trsh-mn/smart-home-iot/docs/images/lamp_v1_schematic.png

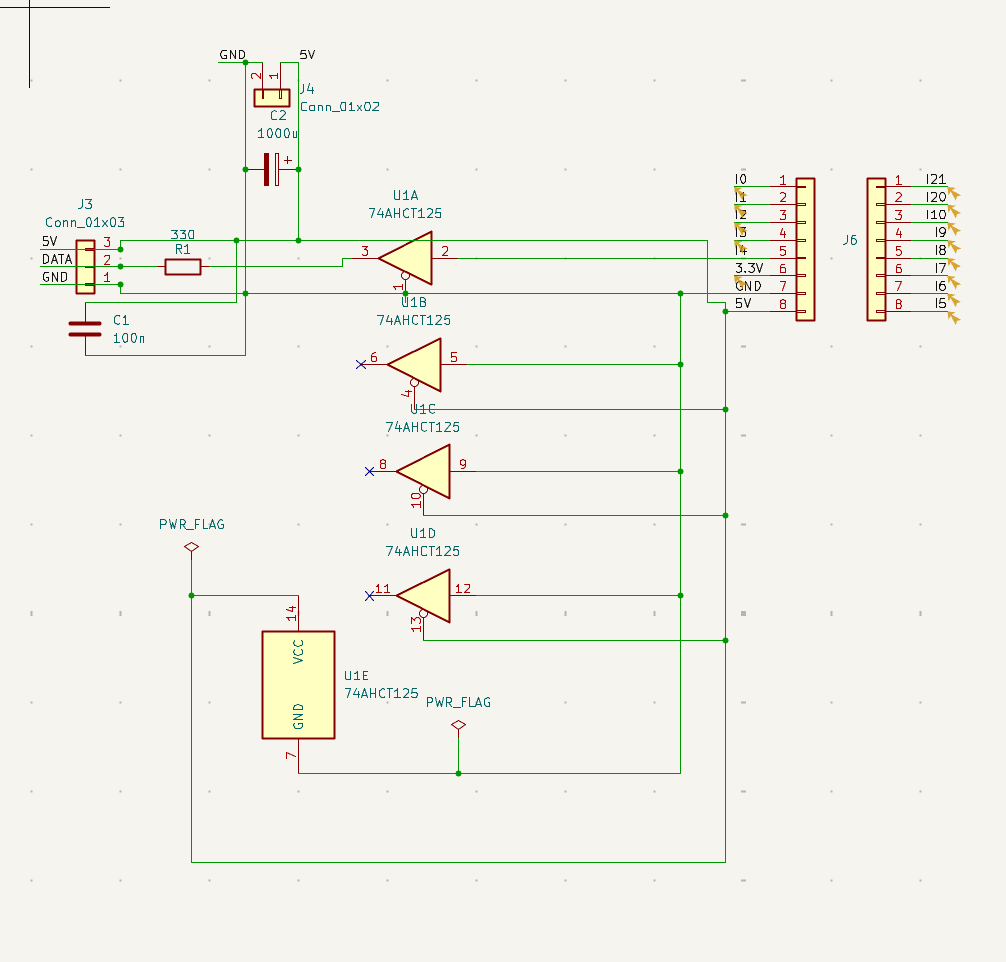
docs/images/lamp_v1_schematic.png
