trsh-mn/smart-home-iot/docs/images/lamp_v2_schematic.png

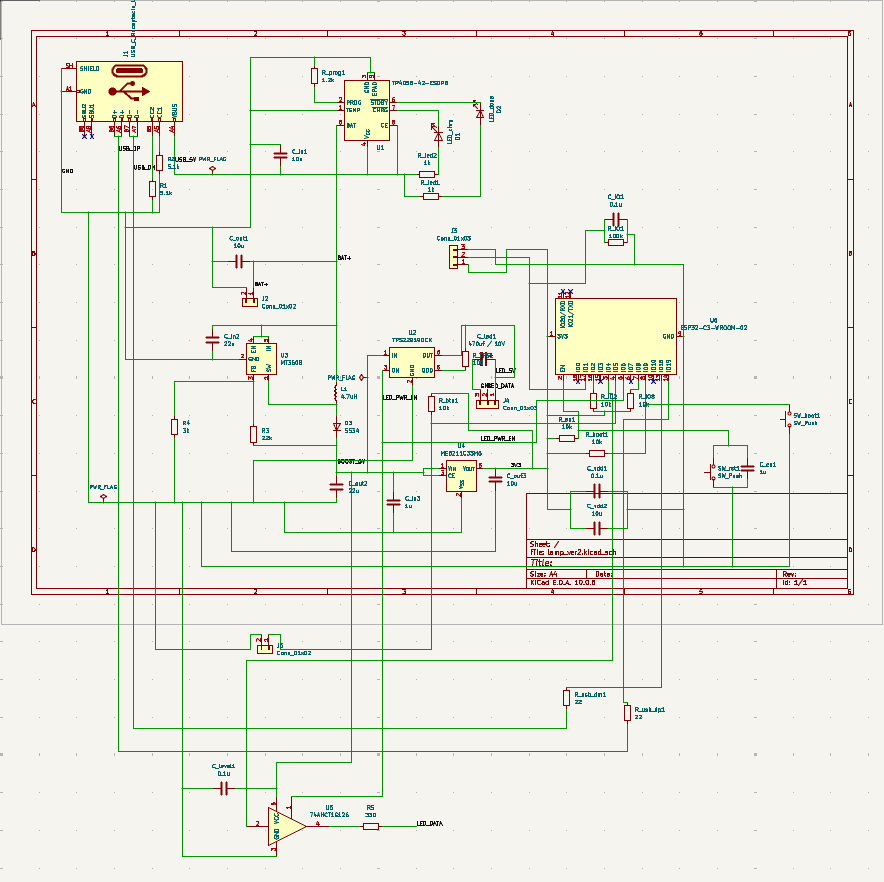
docs/images/lamp_v2_schematic.png
