trsh-mn/smart-home-iot/hardware/lamp_v1/전등.kicad_pcb

## KiCad design hardware/lamp_v1/전등.kicad_pcb (2026-10-02, an earlier design)

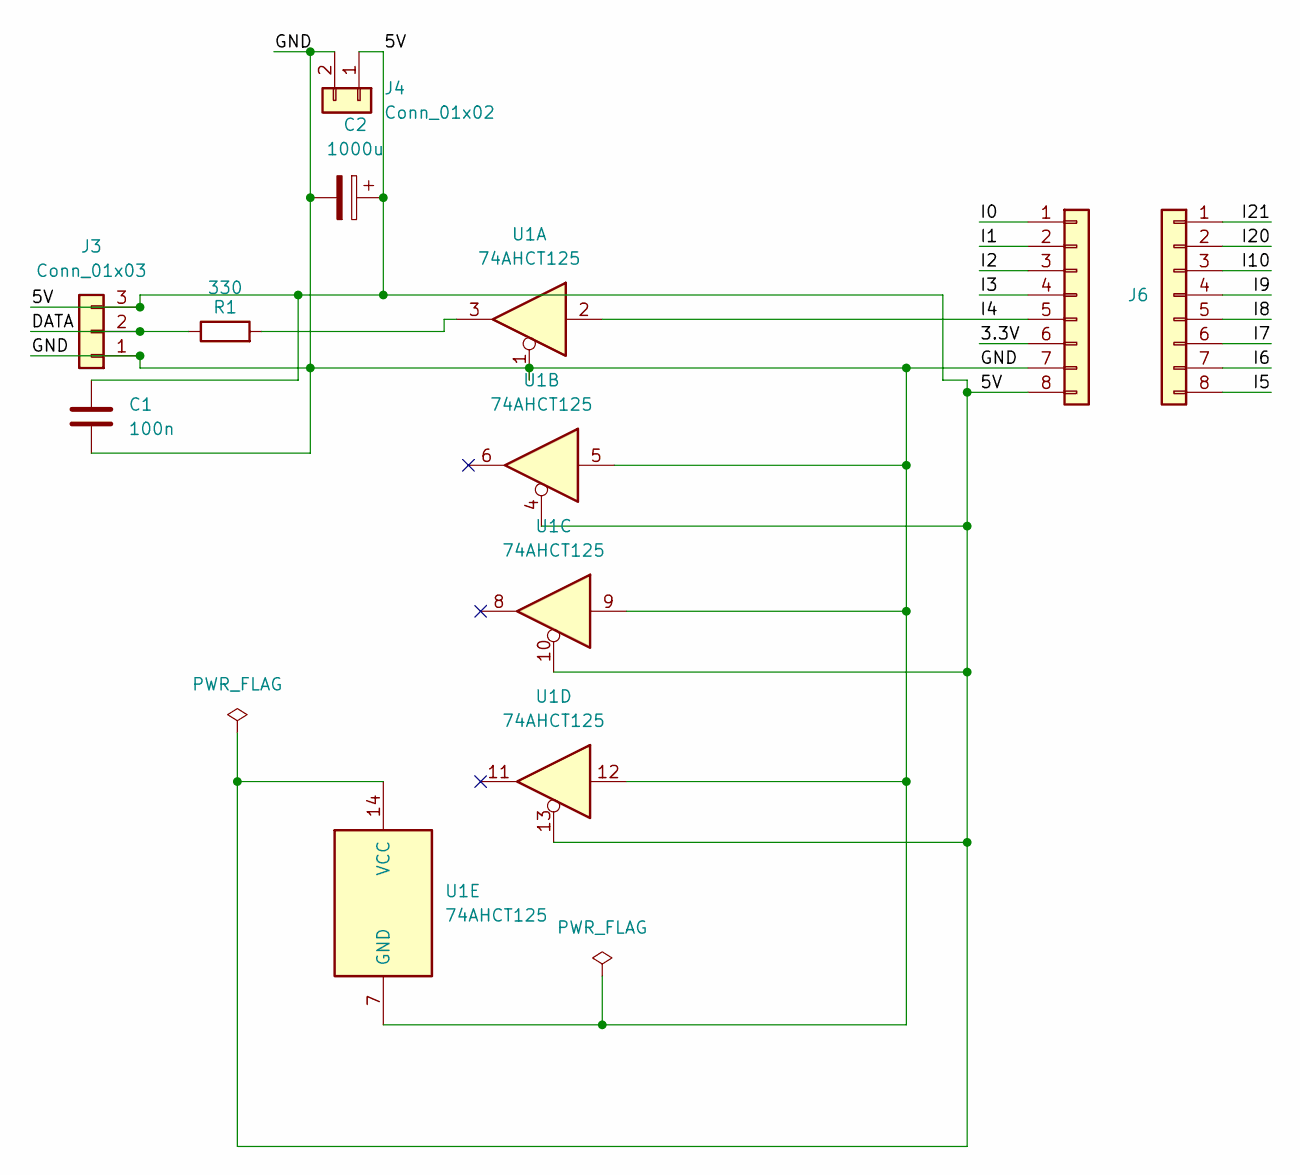
[picture p9: schematic 전등.kicad_sch]

Parts:
C1: 100n; C_0805_2012Metric
C2: 1000u; CP_Radial_D8.0mm_P3.50mm
J3: Conn_01x03; PinHeader_1x03_P2.54mm_Vertical
J4: Conn_01x02; PinHeader_1x02_P2.54mm_Vertical
J5, J6: Conn_01x08; PinSocket_1x08_P2.54mm_Vertical
R1: 330; R_0805_2012Metric
U1: 74AHCT125; SOIC-14_3.9x8.7mm_P1.27mm

Connections:
/3.3V: J5.6
/5V: C1.1, C2.1, J3.3, J4.1, J5.8, U1.4, U1.10, U1.13, U1.14 (VCC)
/DATA: J3.2, R1.1
/GND: C1.2, C2.2, J3.1, J4.2, J5.7, U1.1, U1.5, U1.7 (GND), U1.9, U1.12
/I0: J5.1
/I1: J5.2
/I2: J5.3
/I3: J5.4
/I4: J5.5, U1.2
/I5: J6.8
/I6: J6.7
/I7: J6.6
/I8: J6.5
/I9: J6.4
/I10: J6.3
/I20: J6.2
/I21: J6.1
unnamed: R1.2, U1.3

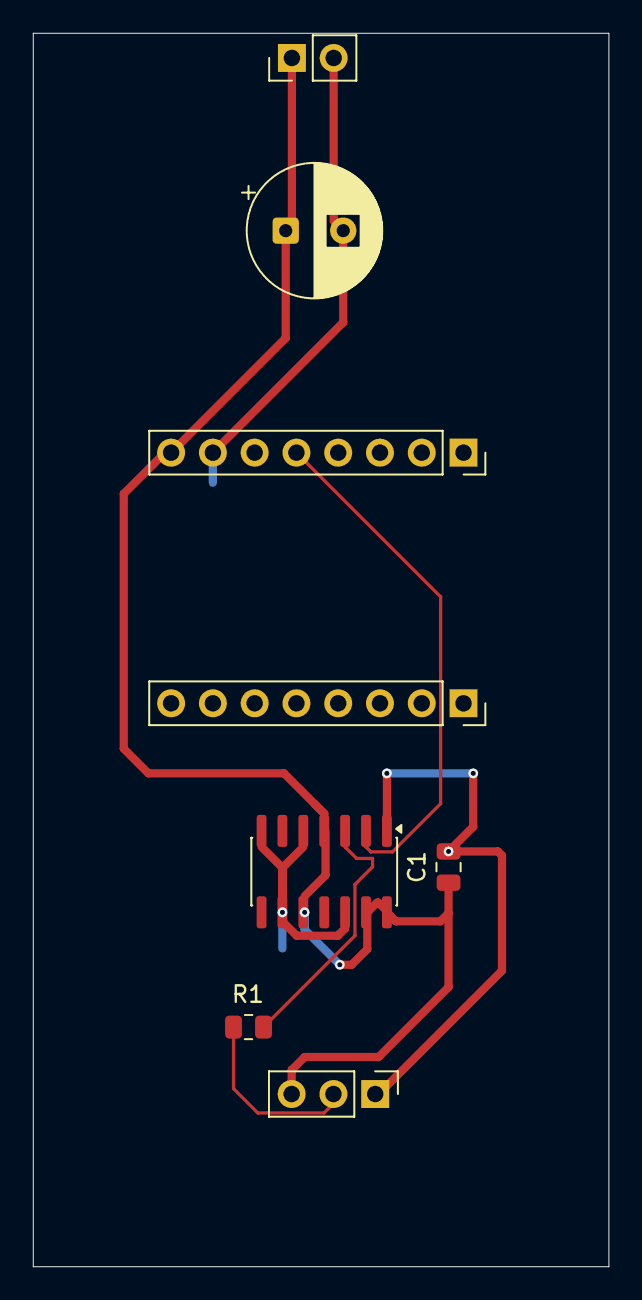
[picture p10: board 전등.kicad_pcb from above]

Board: 2 copper layers, 35.0 x 75.0 mm, 8 parts (0 on the bottom side), 5 nets.
