trsh-mn/smart-home-iot/hardware/lamp_v2/lamp_ver2.kicad_pcb

## KiCad design hardware/lamp_v2/lamp_ver2.kicad_pcb (2026-10-02)

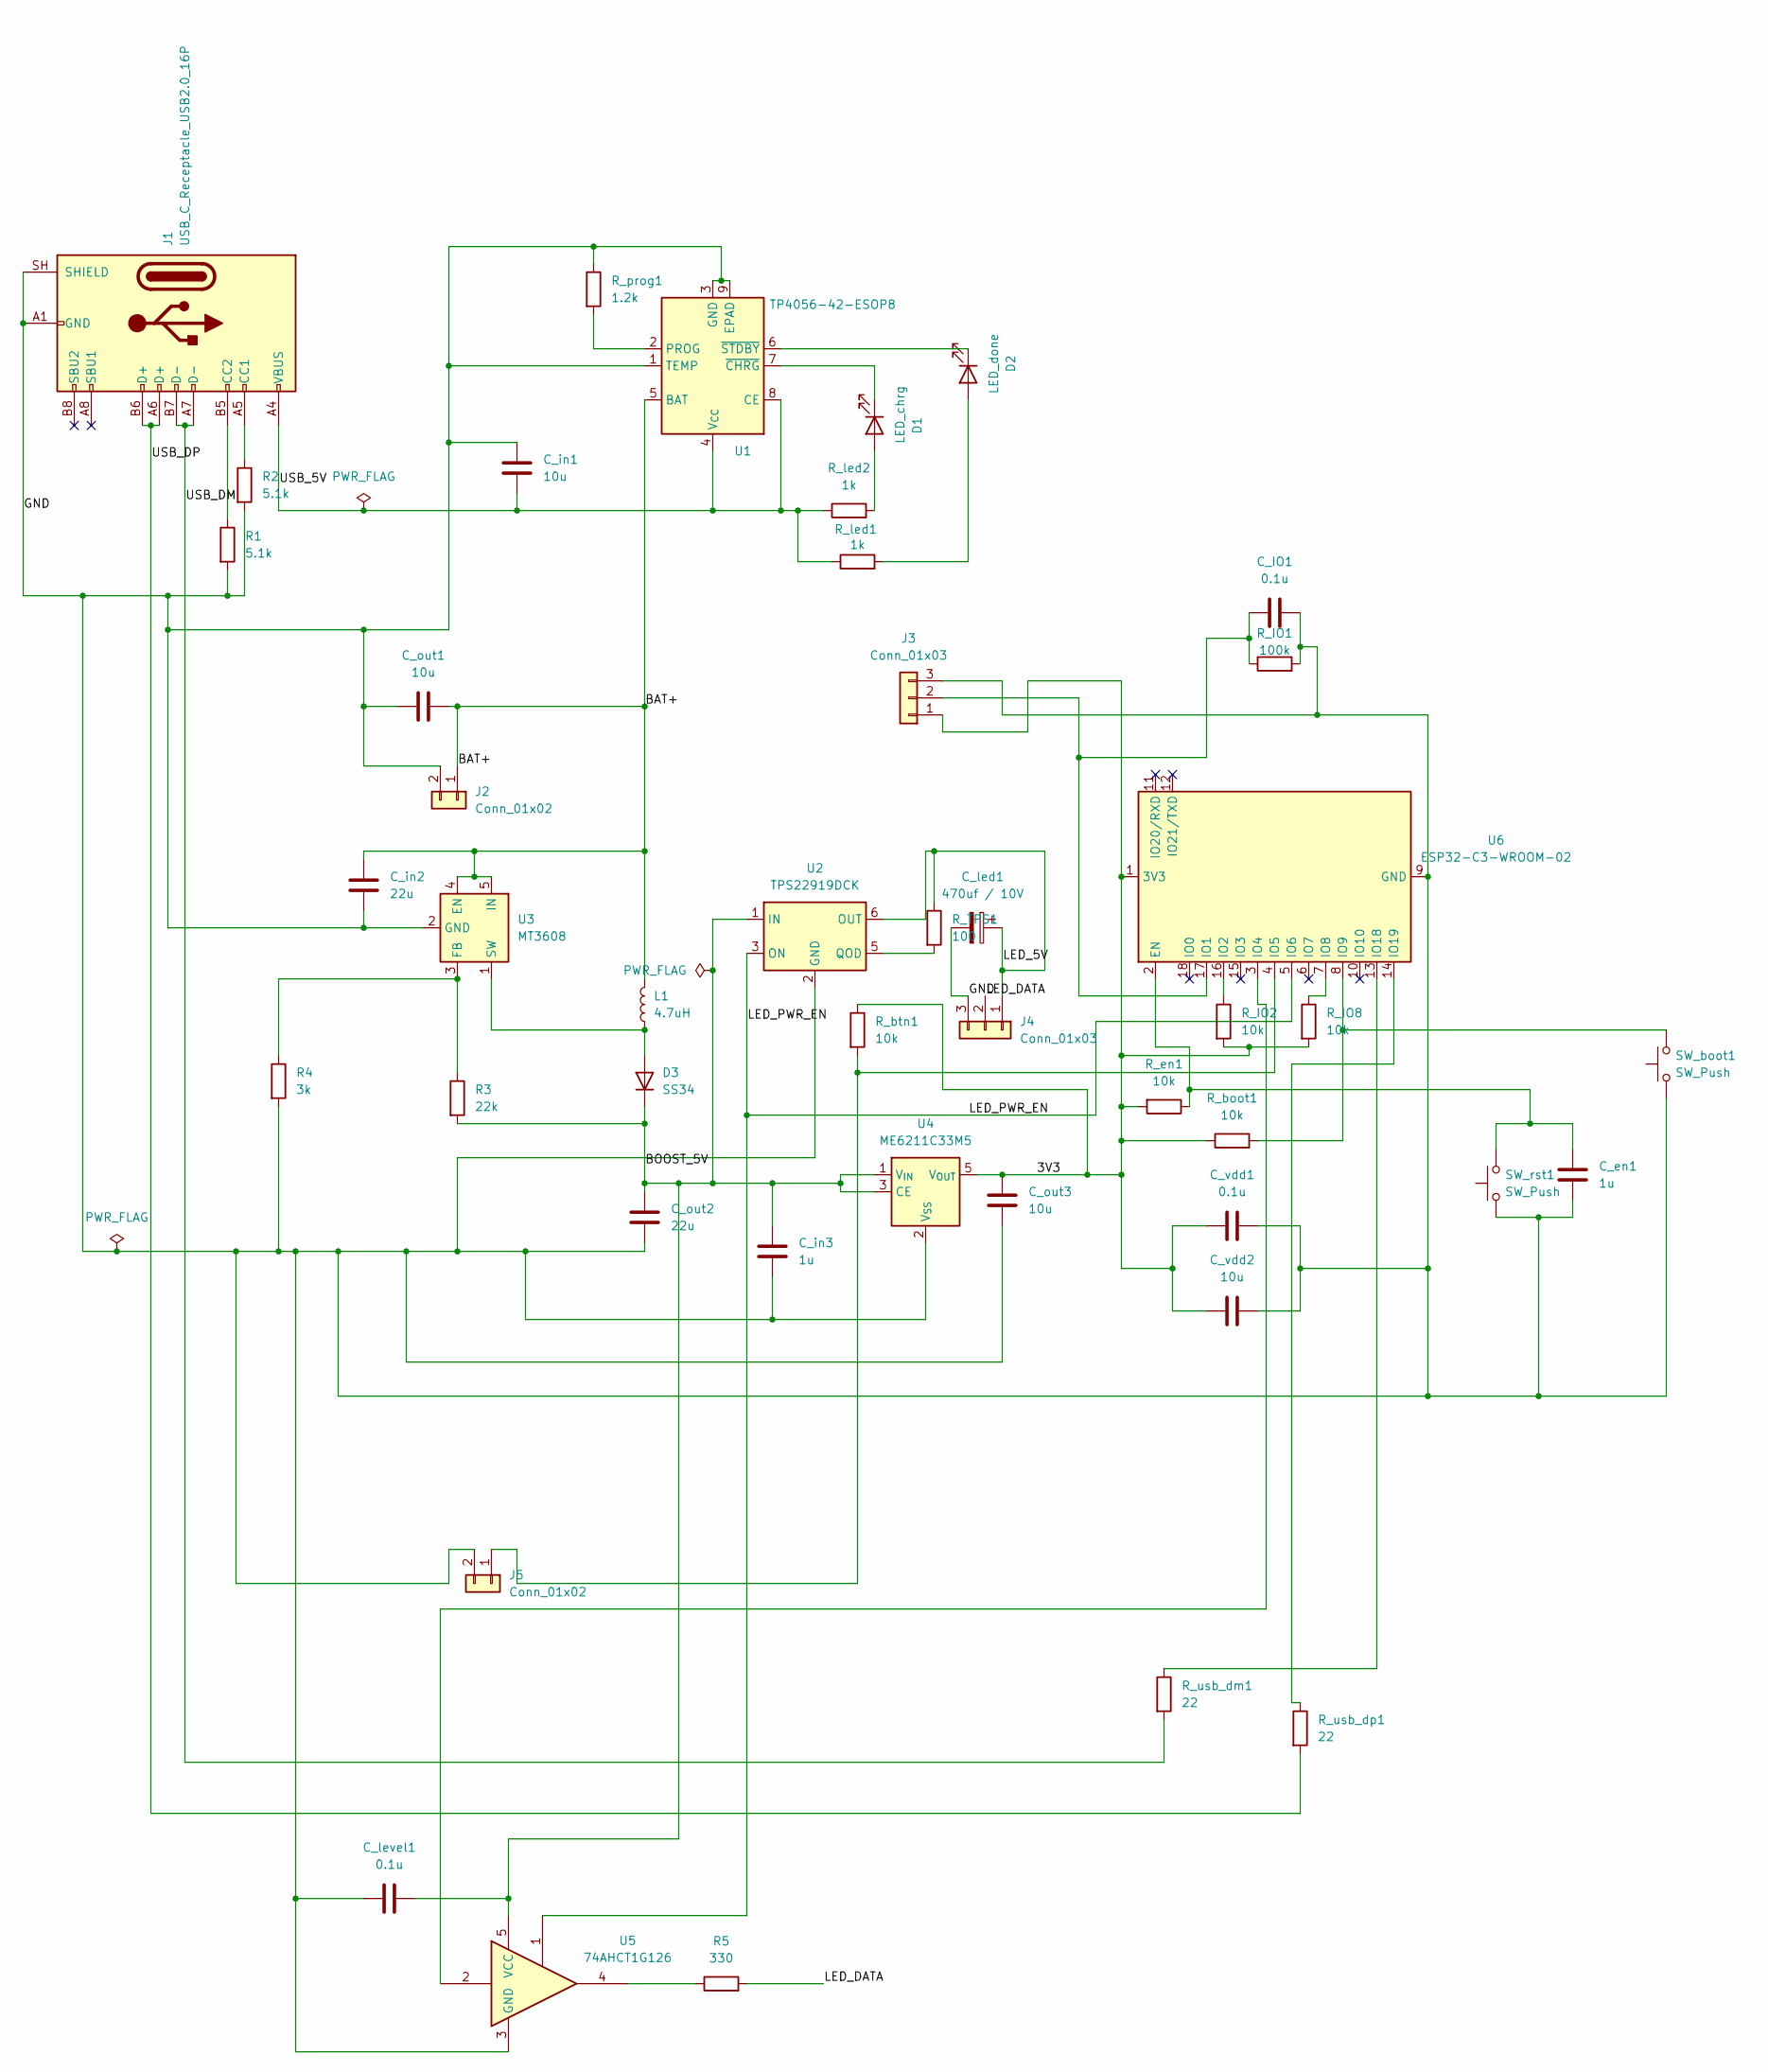
[picture p11: schematic lamp_ver2.kicad_sch]

Parts:
C_IO1: 0.1u; C_0603_1608Metric
C_en1: 1u; C_0603_1608Metric
C_in1: 10u; C_0805_2012Metric
C_in2: 22u; C_1206_3216Metric
C_in3: 1u; C_0603_1608Metric
C_led1: 470uf / 10V; CP_Radial_D6.3mm_P2.50mm
C_level1: 0.1u; C_0603_1608Metric
C_out1, C_out3: 10u; C_0805_2012Metric
C_out2: 22u; C_1206_3216Metric
C_vdd1: 0.1u; C_0603_1608Metric
C_vdd2: 10u; C_0805_2012Metric
D1: LED_chrg; LED_0603_1608Metric
D2: LED_done; LED_0603_1608Metric
D3: SS34; D_SMA
J1: USB_C_Receptacle_USB2.0_16P; USB_C_Receptacle_HRO_TYPE-C-31-M-12
J2, J5: Conn_01x02; JST_XH_B2B-XH-A_1x02_P2.50mm_Vertical
J3, J4: Conn_01x03; JST_XH_B3B-XH-A_1x03_P2.50mm_Vertical
L1: 4.7uH; L_Cenker_CKCS5040
R1, R2: 5.1k; R_0603_1608Metric
R3: 22k; R_0603_1608Metric
R4: 3k; R_0603_1608Metric
R5: 330; R_0603_1608Metric
R_IO1: 100k; R_0603_1608Metric
R_IO2, R_IO8: 10k; R_0603_1608Metric
R_TPS1: 100; R_0603_1608Metric
R_boot1: 10k; R_0603_1608Metric
R_btn1: 10k; R_0603_1608Metric
R_en1: 10k; R_0603_1608Metric
R_led1, R_led2: 1k; R_0603_1608Metric
R_prog1: 1.2k; R_0603_1608Metric
R_usb_dm1: 22; R_0603_1608Metric
R_usb_dp1: 22; R_0603_1608Metric
SW_boot1: SW_Push; SW_SPST_SKQG_WithStem
SW_rst1: SW_Push; SW_SPST_SKQG_WithStem
U1: TP4056-42-ESOP8; SOIC-8-1EP_3.9x4.9mm_P1.27mm_EP2.41x3.3mm
U2: TPS22919DCK; SOT-363_SC-70-6
U3: MT3608; SOT-23-6
U4: ME6211C33M5; SOT-23-5
U5: 74AHCT1G126; SOT-23-5
U6: ESP32-C3-WROOM-02

Connections:
/3V3: C_out3.1, C_vdd1.1, C_vdd2.1, J3.1, R_IO2.2, R_IO8.2, R_boot1.1, R_btn1.1, R_en1.2, U4.5 (V_{OUT}), U6.1 (3V3)
/BAT+: C_in2.1, C_out1.2, J2.1, L1.2, U1.5 (BAT), U3.4 (EN), U3.5 (IN)
/BOOST_5V: C_in3.1, C_level1.2, C_out2.2, D3.1 (K), R3.2, U2.1 (IN), U4.1 (V_{IN}), U4.3 (CE), U5.5 (VCC)
/GND: C_IO1.2, C_en1.1, C_in1.2, C_in2.2, C_in3.2, C_led1.2, C_level1.1, C_out1.1, C_out2.1, C_out3.2, C_vdd1.2, C_vdd2.2, J1.A1 (GND), J1.A12 (GND), J1.B1 (GND), J1.B12 (GND), J1.SH (SHIELD), J2.2, J3.3, J4.3, J5.2, R1.2, R2.2, R4.2, R_IO1.2, R_prog1.1, SW_boot1.1, SW_rst1.1, U1.1 (TEMP), U1.3 (GND), U1.9 (EPAD), U2.2 (GND), U3.2 (GND), U4.2 (V_{SS}), U5.3 (GND), U6.9 (GND), U6.19 (GND)
/LED_5V: C_led1.1, J4.1, R_TPS1.1, U2.6 (OUT)
/LED_DATA: J4.2, R5.2
/LED_PWR_EN: U2.3 (ON), U5.1, U6.5 (IO6)
/USB_5V: C_in1.1, J1.A4 (VBUS), J1.A9 (VBUS), J1.B4 (VBUS), J1.B9 (VBUS), R_led1.1, R_led2.1, U1.4 (V_{CC}), U1.8 (CE)
/USB_DM: J1.A7 (D-), J1.B7 (D-), R_usb_dm1.2
/USB_DP: J1.A6 (D+), J1.B6 (D+), R_usb_dp1.2
unnamed: D1.2 (A), R_led2.2
unnamed: D1.1 (K), U1.7 (~CHRG)
unnamed: D2.2 (A), R_led1.2
unnamed: D2.1 (K), U1.6 (~STDBY)
unnamed: D3.2 (A), L1.1, U3.1 (SW)
unnamed: J1.A5 (CC1), R2.1
unnamed: J1.B5 (CC2), R1.1
unnamed: C_IO1.1, J3.2, R_IO1.1, U6.17 (IO1)
unnamed: J5.1, R_btn1.2, U6.4 (IO5)
unnamed: R5.1, U5.4
unnamed: R_prog1.2, U1.2 (PROG)
unnamed: R_TPS1.2, U2.5 (QOD)
unnamed: R3.1, R4.1, U3.3 (FB)
unnamed: C_en1.2, R_en1.1, SW_rst1.2, U6.2 (EN)
unnamed: R_IO2.1, U6.16 (IO2)
unnamed: U5.2, U6.3 (IO4)
unnamed: R_IO8.1, U6.7 (IO8)
unnamed: R_boot1.2, SW_boot1.2, U6.8 (IO9)
unnamed: R_usb_dm1.1, U6.13 (IO18)
unnamed: R_usb_dp1.1, U6.14 (IO19)

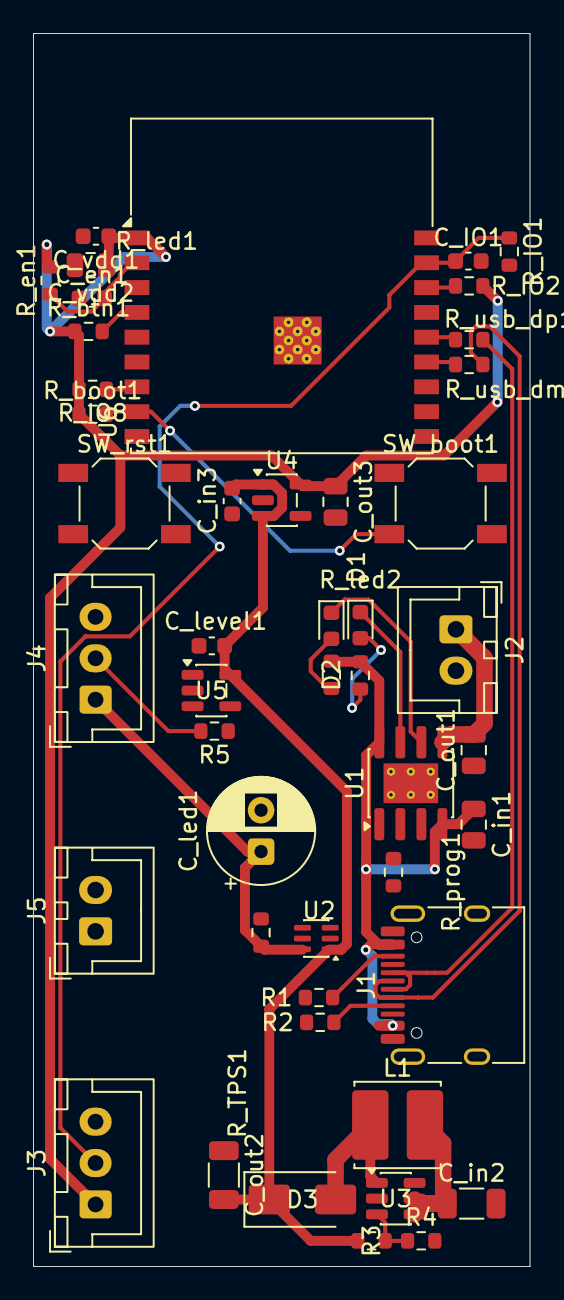
[picture p12: board lamp_ver2.kicad_pcb from above]

Board: 2 copper layers, 30.0 x 74.5 mm, 46 parts (0 on the bottom side), 30 nets.
