trsh-mn/smart-home-iot/firmware/music_speaker/secrets.example.h

// secrets.example.h — 이 파일을 복사해서 secrets.h 로 이름을 바꾸고 값을 채우세요.
// secrets.h 는 GitHub에 올라가지 않습니다 (.gitignore).
#pragma once

const char* WIFI_SSID = "YOUR_WIFI_SSID";
const char* WIFI_PASS = "YOUR_WIFI_PASSWORD";
const char* PI_IP     = "192.168.0.10";   // 라즈베리파이 IP
const char* MQTT_USER = "YOUR_MQTT_USER";
const char* MQTT_PASS = "YOUR_MQTT_PASSWORD";
